MohamedAmr1312/warehouse-robot/electrical circuit/chassis electric circuit.jpg

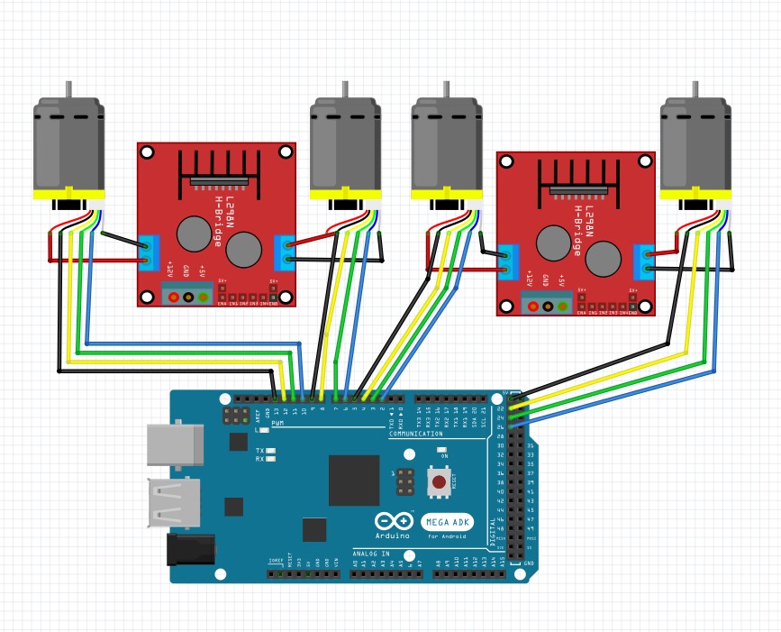
electrical circuit/chassis electric circuit.jpg
