MohamedAmr1312/warehouse-robot/robot full desgin .png

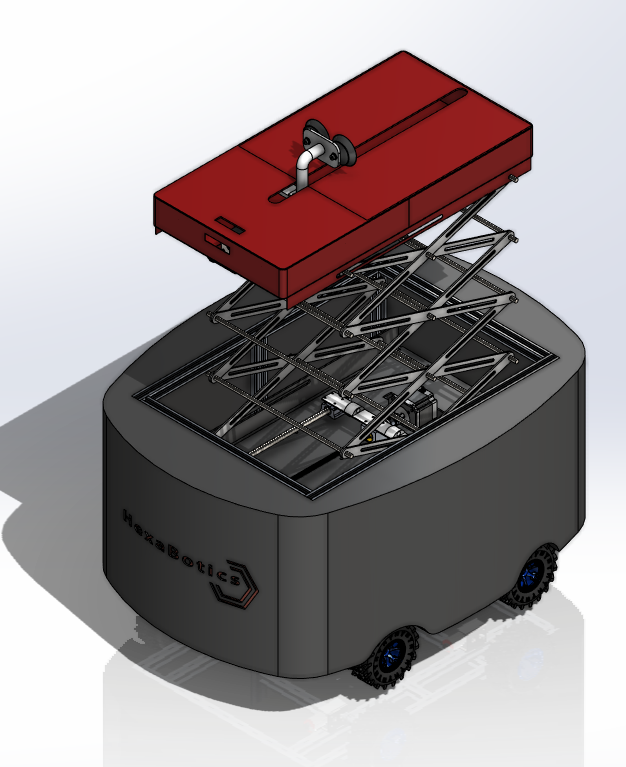
robot full desgin .png
