MohamedAmr1312/warehouse-robot/README.md

# warehouse-robot
warehouse robot consists of 3 subsystems [chassis - scissor lift - gripper mechanism]
