MohamedAmr1312/warehouse-robot/Gripper.docx

There are many grippers that can be used in the autonomous warehouse robot for translating goods. But every type has limitations, then let make a small comparison between some type of gripper and select the suitable one.

Mechanical Grippers

Reliable for handling rigid, consistent shapes like boxes or bins. Can easily apply sufficient force to hold objects up to 35 kg. Simple to design and integrate into robotic systems. The Key Advantage are High gripping strength. But the Limitation is not ideal for irregular or very delicate objects (big box).

Vacuum Grippers

They are effective for smooth, flat surfaces (e.g., plastic, cardboard). Can lift items without damaging them. The Key Advantages are non-intrusive; doesn’t require clamping. Also, can handle objects with varying shapes if the surface is suitable. But they require a robust vacuum system for heavier items and not suitable for porous or irregular surfaces.

Pneumatic Grippers

Can provide strong, consistent gripping force for repetitive tasks. Reliable and fast for handling smaller items within weight limits. Key Advantages compact and lightweight and quick response for high-speed operations. But requires an air compressor. And grip strength may vary depending on the material of the object.

Magnetic Grippers

Effective for handling metal objects, such as metal crates or components. The Key Advantages are No need for physical contact. Simple and robust for heavy loads within 35 kg. but the Limitations that they Only work for ferromagnetic materials and cannot handle non-metallic goods.

Then for the warehouse application, as it doesn’t need high power and high force to hold and move 35 kg of goods, it treats with regular surface (ground) and big volume of goods, and the goods is non-metallic.

Then the suitable gripper that suitable for this requirement and this application is Vacuum Gripper.

Assume

Suction cup diameter = 6 cm (0.06m)

Section cup height = 1 cm (0.01m)

Max weight (m) = 35 Kg

Factor of safety (SF) = 1.5

Vacuum level = 70%

- Dynamic Force

FDynamic = m * a + Fax * µ + (Fax /2)

Fax = Axial load = mload*g

µ = coefficient of fraction

FDynamic = 35 * 0.07 + 0.6 * 343.35 + (343.35/2)= 380 N

- Area of suction cup

Area (A) = π(D/2)² = π (0.06/2)² = 2.8*10⁻³ m²

- Vacuum pressure difference

∆P = (vacuum level * Patm) / 100 = (70 * 101325) / 100 = 70927.5 pa

- Force Gripper

Fgrip = ∆P * A = 200.5 N

As Fgrip < Flift

Then increase the number of suction cup n = 3

Fgrip = 2 * 200.5 = 401 N

Fgrip > Flift (accepted)

- Volume of air removal (V)

V = A * n * h = 3 * 2.8*10⁻³ * 0.01 = 8.4*10⁻⁵ m³ (0.084 L)

- Flow Rate (Q)

Assume the time taken to reach the vacuum level (t) = 5 second

Q = n*V / t =2* 0.084 *60 / 5 = 2.016 L/min

- Power required

Assume the efficiency of vacuum pump (η) = 70%

P = (Q * ∆P) / η = (2.016 * 70927.5) / 1000*60 * 70% = 3.4 W
