MohamedAmr1312/warehouse-robot/lead screw gripper.docx

1. Requirement

Average volume of goods : 500x300x500 mm

Scissor lift base : 600x320x100 mm

Travel distance: 420 mm (0.42 m)

Slide plate : 35 mm

Screw end : 45 mm

Screw length : 500mm

Axial load : 35 Kg

Linear speed : 70 mm/sec (0.07 m/sec)

Linear accuracy: 0.5 mm (How much travel accuracy is needed ball screw itself)

Travel tolerance = 420 ± 0.5 mm

2. Lead screw Calculation
I. Maximum Axial load on lead screw

Maximum load = 35 Kg + 0.65 (table)

Axial force = load * g = 35.65 Kg * 9.81 m/sec² = 349.37 N

Then Static load = 349.37 N

Dynamic load = Fax +mass * a + Fax * µ

Fax = Axial load

µ = coefficient of fraction

from equation motion : V² = V0² + 2ad

then, a = V / ta = 0.07 / 0.5 = 0.14 m/sec²

dynamic load (maximum load) = 349.37 + 35 * 0.07 + 0.6 * 349.37 = 564 N

Column Loading Capacities Chart

Use the chart below to determine the Maximum Compression Load for Screw Shaft. Usually, screws operated in tension can handle loads up to the rated capacity of the nut, providing the screw length is within standard lengths. End supports have an effect on the load capacity of screws. The four standard variations are shown below with corresponding rating adjustments. Find the point of intersecting lines of load (horizontal) and length (vertical) to determine the minimum safe diameter of screw.

Then the suitable diameter is between 8 and 10 mm

Then considering the diameter of screw = 8 mm

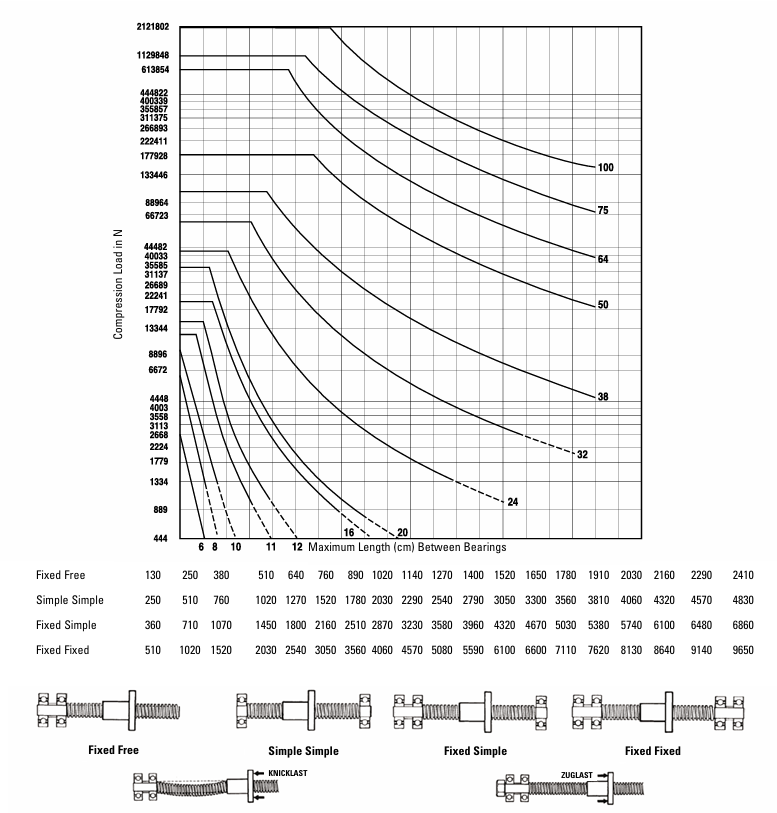
[picture p3: figure]

II. Lead selection

Lead = Vmax linear speed (mm/s) * 60 / Nmax rotational speed of motor (RPM)

a) length of lead screw = 500 mm
b) speed of the motor
- by using stepper motor then the maximum speed is up to 3000 RPM

then,

lead ≥ 70*60/2500 ≥ 1.68 mm

considering lead = 2 mm

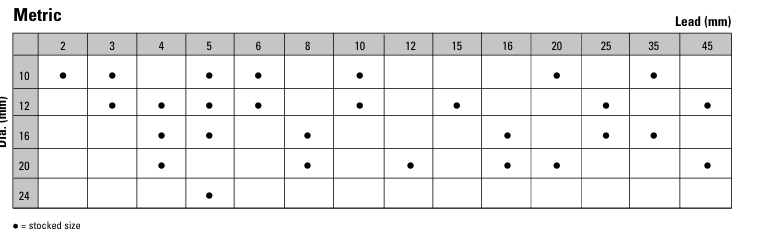
[picture p4: figure]
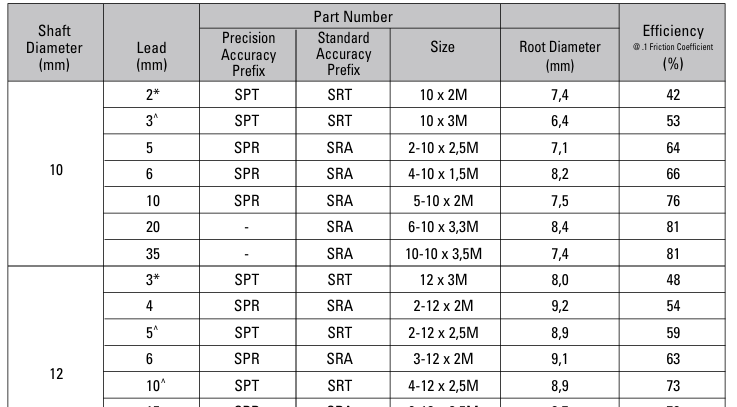
[picture p5: figure]

the efficiency = 42 %

III. Maximum Rotational speed RPM

Every screw shaft has a rotational speed limit. That is the point at which the rotational speed sets up excessive vibration. This critical point is modified by the type of end bearing support used. To use this chart, determine the required RPM and the maximum length between bearing supports. Next, select one of the four types of end support shown below. The critical speed limit can be found by locating the point at which the RPM (horizontal lines) intersects with the unsupported screw length (vertical lines) as modified by the type of supports select below.

Nmax = (Vmax * 60) / lead

Nmax = (70 * 60) / 2 = 2100 RPM

Permissible rotation speed

Np > 3000 RPM

Then,

Max Rotational speed > Permissible Speed

Selection is approved

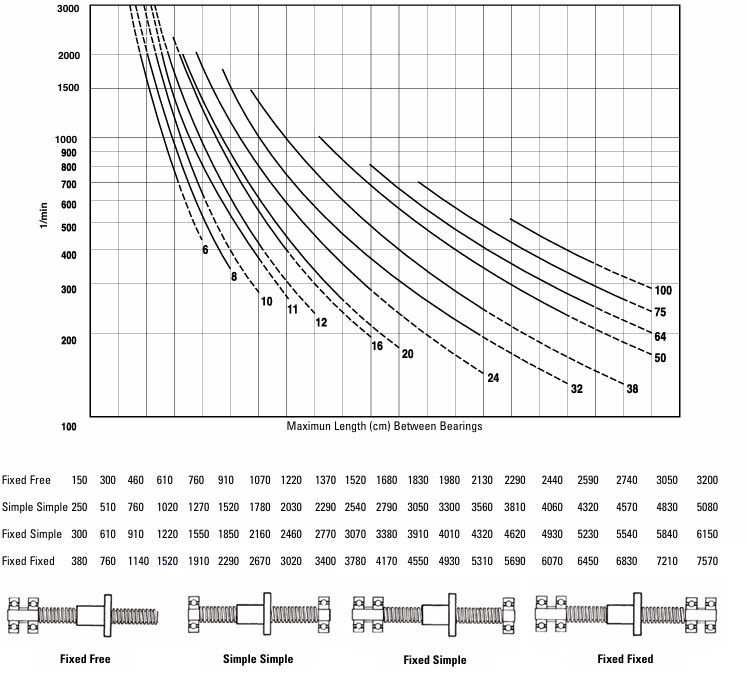
[picture p6: figure]

T8 lead screw [D= 8mm, L= 2mm]
