MohamedAmr1312/warehouse-robot/motor sizing gripper.docx

1. Requirement

Average volume of goods : 500x300x500 mm

Scissor lift base : 600x400x100 mm

Travel distance: 420 mm (0.42 m)

Slide plate : 35 mm

Screw end : 45 mm

Screw length : 500mm

Axial load : 35 Kg

Linear speed : 70 mm/sec (0.07 m/sec)

Time accelerate (ta) = time decelerate (td) = 0.5 sec

Time constant (tc) = 5 sec

2. Motion Porfile

Pitch (P) =2 mm

Efficiency (e)= 42%

Stroke (S)=420 mm =0.42 m

tc = 5 sec

Vmax = 0.7/10 = 0.07 m/sec

Wmax = Vmax * (2π/P) = 219.9 rad/sec

αmax= Wmax / ta = 219.9/0.5 = 440 rad/sec²

3. Inertia

mload = 35 Kg

mscrew = ρ* πrscrew² *L = 7.75 *10³ *π (0.008/2)²*0.5 = 0.19 Kg

ρ=7.75 g/cm² – Dscew = 8mm

mtable = 654.66 g = 0.65 Kg

mcoupling = 0.025 Kg

Motor coupling inertia:

JC = ½ mcoupling *rcoupling² = ½ * 0.025 * (0.019/2)² = 1.13x10⁻⁶ Kg.m²

Screw inertia :

JS = ½ mscrew *rscrew² = ½ *0.19*(0.008/2)² = 1.5x10⁻⁶ Kg.m²

Belt inertia reflected to Motor:

JT—m = mtable/ e *( P/2π)² = 0.65 / 0.42 *(0.002/2π)² = 1.6x10⁻⁷ Kg.m²

Load inertia reflected to Motor:

JL—m = mLoad/ e *( P/2π)² = 35 / 0.42 *(0.002/2π)² = 8.4x10⁻⁶ Kg.m²

Total inertia:

Jtotal = JC + JS + JT—m + JL—m = 1.12x10⁻⁵ Kg.m²

Ta = Jtotal* αmax = 5x10⁻³ N.m

Tc = Tfr = (µ * mload * g)/e *(p/2 π) = 0.156 N.m

[µ = 0.6 , g = 9.8 N.m]

Torque during acceleration (Tmax) = Ta + Tc = 0.16 N.m

Torque during deceleration = 0

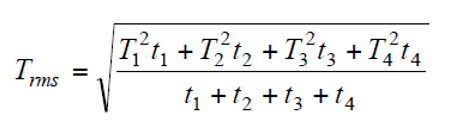
[picture p12: figure]

Torque rms: Trms = 0.14 Nm

Max RPM:

RPMmax = Wmax (60/2 π) = 2100 rpm

Ta + Tc

The suitable motor is stepper motor NEMA 17

4. power requirement

Power is the measure of the rate at which work is done or energy is transferred. In electric motors, power calculation is essential for determining efficiency, selecting the right motor for an application, and ensuring optimal performance.

P = τmax × ω

P= 2 π N τmax /60

P= 35.2 W
