MohamedAmr1312/warehouse-robot/motor sizing screw of scissor lift.docx

1. Requirement

Average volume of goods : 500x300x500 mm

Scissor lift base : 600x400x100 mm

Travel distance: 250 mm (0.25 m)

Slide plate : 35 mm

Screw end : 35 mm

Screw length : 322mm

Axial load : 35 + 10 = 45 Kg

Linear speed : 50 mm/sec (0.05 m/sec)

Time accelerate (ta) = time decelerate (td) = 0.5 sec

Time constant (tc) = 4 sec

2. Motion Porfile

Pitch (P) =2 mm

Efficiency (e)= 42%

Stroke (S)=250 mm =0.25 m

tc = 4 sec

Vmax = 0.5/10 = 0.05 m/sec

Wmax = Vmax * (2π/P) = 157.08 rad/sec

αmax= Wmax / ta = 157.08/0.5 = 314.14 rad/sec²

3. Inertia

mload = 45 Kg

mscrew = ρ* πrscrew² *L = 7.75 *10³ *π (0.008/2)²*0.322 = 0.125 Kg

ρ=7.75 g/cm² – Dscew = 8mm

mtable = 654.66 g = 0.65 Kg

mcoupling = 0.025 Kg

Motor coupling inertia:

JC = ½ mcoupling *rcoupling² = ½ * 0.025 * (0.019/2)² = 1.13x10⁻⁶ Kg.m²

Screw inertia :

JS = ½ mscrew *rscrew² = ½ *0.125*(0.008/2)² = 1x10⁻⁶ Kg.m²

Belt inertia reflected to Motor:

JT—m = mtable/ e *( P/2π)² = 0.65 / 0.42 *(0.002/2π)² = 1.6x10⁻⁷ Kg.m²

Load inertia reflected to Motor:

JL—m = mLoad/ e *( P/2π)² = 45 / 0.42 *(0.002/2π)² = 1.1x10⁻⁵ Kg.m²

Total inertia:

Jtotal = JC + JS + JT—m + JL—m = 1.3x10⁻⁵ Kg.m²

Ta = Jtotal* αmax = 4.08x10⁻³ N.m

Tc = Tfr = (µ * mload * g)/e *(p/2 π) = 0.201 N.m

[µ = 0.6 , g = 9.8 N.m]

Torque during acceleration (Tmax) = Ta + Tc = 0.205 N.m

Torque during deceleration = 0


Torque rms: Trms = 0.18 Nm

Max RPM:

RPMmax = Wmax (60/2 π) = 1500 rpm

Ta + Tc

The suitable motor is stepper motor NEMA 17

4. power requirement

Power is the measure of the rate at which work is done or energy is transferred. In electric motors, power calculation is essential for determining efficiency, selecting the right motor for an application, and ensuring optimal performance.

P = τmax × ω

P= 2 π N τmax /60

P= 32.2 W
