MohamedAmr1312/warehouse-robot/electrical circuit/circuit of scissor & gripper mechanism.png

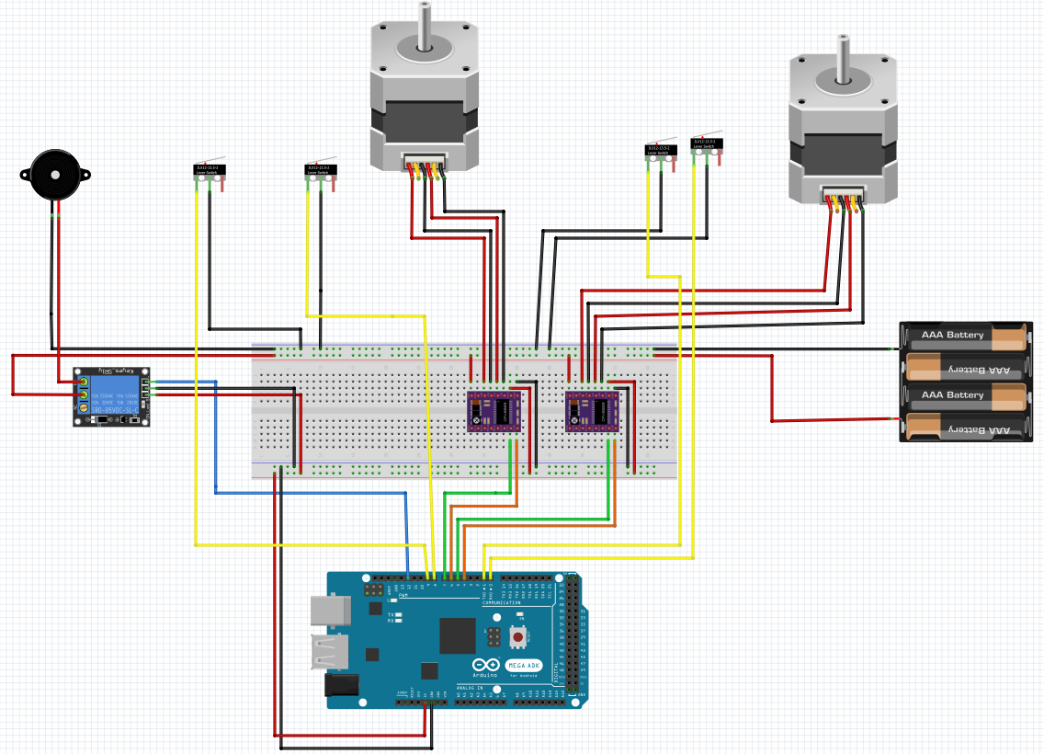
electrical circuit/circuit of scissor & gripper mechanism.png
