MohamedAmr1312/warehouse-robot/warehouse robot.SLDASM

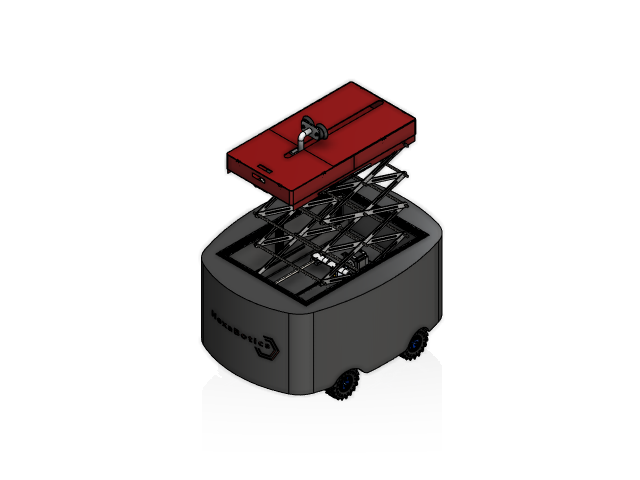
[picture p16: CAD file, 2025-05-02]
warehouse robot.SLDASM
20x20_aluminum_extrusion_profile_300mm x 6
20x20_aluminum_extrusion_profile_400mm x 8
20x20_aluminum_extrusion_profile_600mm x 4
20x20_aluminum_extrusion_profile_270mm x 5
JGY-370-1285_Motor x 4
JGY-370-1285_Motor_Holder x 4
Power Screw Bearing Part - KP08 SUPPORT BEARING-Edited x 5
KPO8_Support_Plate x 4
8x4.4_shaft x 4
Wheel coupler x 4
Tyre x 4
Plastic Rim x 4
Coupler 6.35-8mm x 3
Grub Screw M4x6mm x 12
V1.3
sessicor lower base
sk8_rod_holder_v2 x 8
KP08 x 4
608RS x 4
screw-rod x 2
shaft1 scissor lift x 2
screw-nut x 2
Up.step
Axe.step
Bottom.step
Middle.step
M2x50-Screw.step x 4
Sticker.step
Rubber.step
RedWire.step
GreenWire.step
BlueWire.step
YellowWire.step
NEMA 17 & 23-Body
nut housing and rod holder connecter 2
SC8UU x 4
nut housing T8 x 2
shaft1 x 2
nut housing and rod holder connecter
Base Plate
Back Plate
Axial Rod
instrument ball bearing_68_am x 2
pan cross head_am x 4
Nema17-Size42
14 flex coupler
upper base mechanism
Lim_1 x 2
lim_2 x 2
Lim_3 x 2
Lim_5 x 2
vacuum pump holder
SYPDA Diaphragm pump MV-SD820
screw-rodof vacuum pump x 2
hex flange nut_am x 4
upper mechanism case
Suction_cup x 2
suction cup holder plate
new suction cup holder
Gripping_Bracket_Support x 8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
