MohamedAmr1312/warehouse-robot/Motor selection (Second approach)_V6.0.pdf

Weight of each subsystem:
Chassis subsystem = 6.1 Kg Scissor lift mechanism = 7.5 kg Package gripping Mechanism = 7.5 Kg Payload = 30 Kg

Total weight = 51.1 Kg
1. Let the nominal speed (Vmax) = 0.5 m/s
2.Time for acceleration = 3 sec. -> a = Vmax/Ta = 0.5/3 = 0.16m/sec^2
3. Wheel’s diameter (Dw) = 130mm = 0.13m
4.Thickness of the wheel(Tw) = 59mm = 0.059m
5.Mass of the wheel (Mw) = 173 gm = 0.173 kg
6.Weight of the wheel (Ww) = 0.173 * 9.81 = 1.7 N

Calculate the traction wheel rotation speed :
Nt = (60* Vmax) / TT * Dw = 73.45 =~ 74 RPM

Calculate the thrust force (Ft):
Ft = U*g(total load ) = 17.54N
g -> acceleration Due to gravity = 9.81
U -> coefficient of friction = 0.035 (needs to be reconsidered)

Power Required:
Pu = Ft * Vmax = 8.77 watt , therfore each motor of the four drive motors needs 2.2 Watt to operate

### Motor selection (Second approach)

Specifications of the wheels:
Outer diameter of wheel: 130mm Thickness: 59mm
Brass coupler inner diameter: 4mm

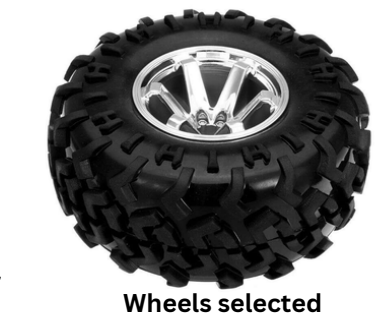
[picture p17: figure]
Wheels selected

Interior six-angle side to side for 12mm (for Hex Coupler)
Weight: 173 gr (each wheel with mounting hub)

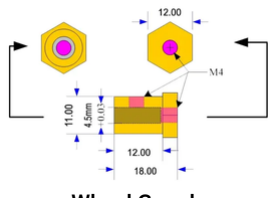
[picture p18: figure]

Wheel Coupler

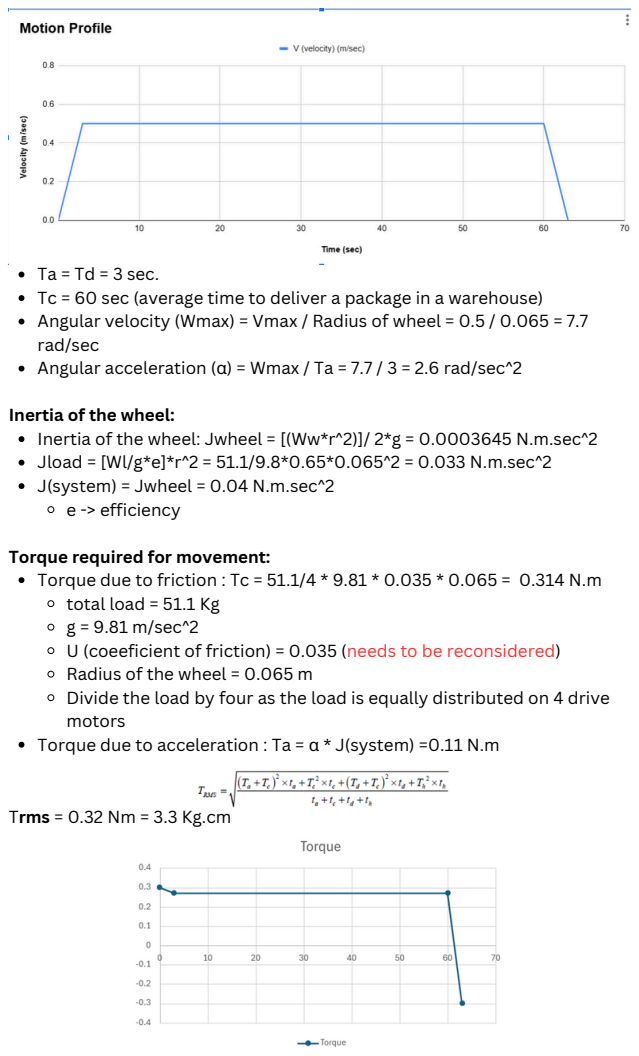
[picture p19: page 2]

Ta = Td = 3 sec.
Tc = 60 sec (average time to deliver a package in a warehouse)
Angular velocity (Wmax) = Vmax / Radius of wheel = 0.5 / 0.065 = 7.7
rad/sec
Angular acceleration (α) = Wmax / Ta = 7.7 / 3 = 2.6 rad/sec^2

Inertia of the wheel:
Inertia of the wheel: Jwheel = [(Ww*r^2)]/ 2*g = 0.0003645 N.m.sec^2
Jload = [Wl/g*e]*r^2 = 51.1/9.8*0.65*0.065^2 = 0.033 N.m.sec^2
J(system) = Jwheel = 0.04 N.m.sec^2
e -> efficiency

Torque required for movement:
Torque due to friction : Tc = 51.1/4 * 9.81 * 0.035 * 0.065 = 0.314 N.m
total load = 51.1 Kg
g = 9.81 m/sec^2
U (coeeficient of friction) = 0.035 (needs to be reconsidered)
Radius of the wheel = 0.065 m
Divide the load by four as the load is equally distributed on 4 drive
motors
Torque due to acceleration : Ta = α * J(system) =0.11 N.m

Trms = 0.32 Nm = 3.3 Kg.cm
